RJTPP/S-ADAPT-IoT/docs/README.md

# Documentation Index

Current implementation source-of-truth docs are under `docs/architecture/` and `docs/planning/`.
Files under `docs/references/` are preserved reference artifacts and may describe earlier design intent.

## Architecture
- [`docs/architecture/Architecture.md`](architecture/Architecture.md)
- [`docs/architecture/business-logic.md`](architecture/business-logic.md)
- [`docs/architecture/Schematic_S-ADAPT.png`](architecture/Schematic_S-ADAPT.png)
- [`docs/architecture/design_EasyDEA.json`](architecture/design_EasyDEA.json)
- [`docs/user-guide.md`](user-guide.md)
- [`docs/feature-matrix.md`](feature-matrix.md)

## Planning
- [`docs/planning/planning-checklist.md`](planning/planning-checklist.md)
- [`docs/planning/test-checklist.md`](planning/test-checklist.md)

## References
- [`docs/references/Project Proposal.md`](references/Project%20Proposal.md)
- [`docs/references/Project Proposal_S-ADAPT-rev2.pdf`](references/Project%20Proposal_S-ADAPT-rev2.pdf)
- [`docs/references/NUCLEO-L432KC_pinout.png`](references/NUCLEO-L432KC_pinout.png)
