RJTPP/S-ADAPT-IoT/S-ADAPT/Core/Src/main.c

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
/* Includes ------------------------------------------------------------------*/
#include "main.h"

/* USER CODE BEGIN Includes */
#include "support/debug_print.h"
#include "app/app.h"
/* USER CODE END Includes */

ADC_HandleTypeDef hadc1;

I2C_HandleTypeDef hi2c1;

TIM_HandleTypeDef htim1;
TIM_HandleTypeDef htim2;

UART_HandleTypeDef huart2;

void SystemClock_Config(void);
static void MX_GPIO_Init(void);
static void MX_USART2_UART_Init(void);
static void MX_TIM2_Init(void);
static void MX_I2C1_Init(void);
static void MX_TIM1_Init(void);
static void MX_ADC1_Init(void);
/**
  * @brief  The application entry point.
  * @retval int
  */
int main(void)
{

  /* MCU Configuration--------------------------------------------------------*/

  /* Reset of all peripherals, Initializes the Flash interface and the Systick. */
  HAL_Init();

  /* Configure the system clock */
  SystemClock_Config();

  /* Initialize all configured peripherals */
  MX_GPIO_Init();
  MX_USART2_UART_Init();
  MX_TIM2_Init();
  MX_I2C1_Init();
  MX_TIM1_Init();
  MX_ADC1_Init();
  /* USER CODE BEGIN 2 */
  debug_print_init(&huart2);
  debug_print_set_level(DEBUG_PRINT_DEBUG);
  debug_println("Boot start");
  debug_println("App mode");
  {
    app_hw_config_t hw = {
      .ldr_adc = &hadc1,
      .echo_tim = &htim2,
      .echo_channel = TIM_CHANNEL_2,
      .main_led_tim = &htim1,
      .main_led_channel = TIM_CHANNEL_1
    };

    if (app_init(&hw) == 0U)
    {
      debug_logln(DEBUG_PRINT_ERROR, "app init degraded mode");
      app_set_fatal_fault(1U);
      debug_logln(DEBUG_PRINT_ERROR, "safe mode: fatal fault indication active");
    }
  }
  /* USER CODE END 2 */

  /* Infinite loop */
  /* USER CODE BEGIN WHILE */
  while (1)
  {
    app_step();
    HAL_Delay(1);
    /* USER CODE END WHILE */

    /* USER CODE BEGIN 3 */
  }
  /* USER CODE END 3 */
}

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
/* USER CODE BEGIN 4 */
void HAL_GPIO_EXTI_Callback(uint16_t GPIO_Pin)
{
  if ((GPIO_Pin == ENCODER_CLK_EXTI1_Pin) || (GPIO_Pin == ENCODER_DT_EXTI10_Pin))
  {
    encoder_input_on_clk_edge_isr();
  }
}
/* USER CODE END 4 */
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
