RJTPP/S-ADAPT-IoT/S-ADAPT/Core/Inc/main.h

#define TRIG_Pin GPIO_PIN_0
#define TRIG_GPIO_Port GPIOA
#define ECHO_TIM2_CH2_Pin GPIO_PIN_1
#define ECHO_TIM2_CH2_GPIO_Port GPIOA
#define VCP_TX_Pin GPIO_PIN_2
#define VCP_TX_GPIO_Port GPIOA
#define BUTTON_Pin GPIO_PIN_0
#define BUTTON_GPIO_Port GPIOB
#define ENCODER_CLK_EXTI1_Pin GPIO_PIN_1
#define ENCODER_CLK_EXTI1_GPIO_Port GPIOB
#define Main_LED_TIM1_CH1_Pin GPIO_PIN_8
#define Main_LED_TIM1_CH1_GPIO_Port GPIOA
#define ENCODER_PRESS_Pin GPIO_PIN_9
#define ENCODER_PRESS_GPIO_Port GPIOA
#define ENCODER_DT_EXTI10_Pin GPIO_PIN_10
#define ENCODER_DT_EXTI10_GPIO_Port GPIOA
#define LED_Status_B_Pin GPIO_PIN_11
#define LED_Status_B_GPIO_Port GPIOA
#define SWDIO_Pin GPIO_PIN_13
#define SWDIO_GPIO_Port GPIOA
#define SWCLK_Pin GPIO_PIN_14
#define SWCLK_GPIO_Port GPIOA
#define VCP_RX_Pin GPIO_PIN_15
#define VCP_RX_GPIO_Port GPIOA
#define LED_Status_R_Pin GPIO_PIN_4
#define LED_Status_R_GPIO_Port GPIOB
#define LED_Status_G_Pin GPIO_PIN_5
#define LED_Status_G_GPIO_Port GPIOB
#define OLED_I2C_SCL_Pin GPIO_PIN_6
#define OLED_I2C_SCL_GPIO_Port GPIOB
#define OLED_I2C_SDA_Pin GPIO_PIN_7
#define OLED_I2C_SDA_GPIO_Port GPIOB
