RJTPP/S-ADAPT-IoT/S-ADAPT/Core/Src/input/switch_input.c

#include "input/switch_input.h"

#include "input/input_utils.h"
#include "main.h"

#define SWITCH_SAMPLE_PERIOD_MS 10U
#define SWITCH_DEBOUNCE_TICKS   2U
#define SWITCH_EVENT_QUEUE_SIZE 8U

typedef struct
{
    uint8_t stable_level;
    uint8_t candidate_level;
    uint8_t candidate_ticks;
} switch_state_t;

typedef struct
{
    GPIO_TypeDef *port;
    uint16_t pin;
    switch_input_id_t id;
} switch_config_t;

#define SWITCH_INPUT_COUNT 2U

static const switch_config_t s_switch_configs[SWITCH_INPUT_COUNT] = {
    {BUTTON_GPIO_Port, BUTTON_Pin, SWITCH_INPUT_BUTTON},
    {ENCODER_PRESS_GPIO_Port, ENCODER_PRESS_Pin, SWITCH_INPUT_SW2},
};

static switch_state_t s_switch_states[SWITCH_INPUT_COUNT];
static uint32_t s_last_sample_ms = 0U;

static switch_input_event_t s_event_queue[SWITCH_EVENT_QUEUE_SIZE];
static uint8_t s_queue_head = 0U;
static uint8_t s_queue_tail = 0U;
static uint8_t s_queue_count = 0U;

static void init_switch_state(switch_state_t *state, const switch_config_t *config)
{
    uint8_t level = input_gpio_level(config->port, config->pin);
    state->stable_level = level;
    state->candidate_level = level;
    state->candidate_ticks = 0U;
}

static void queue_push(switch_input_id_t input, uint8_t level)
{
    switch_input_event_t event;
    uint32_t primask;

    primask = input_irq_lock();
    if (s_queue_count < SWITCH_EVENT_QUEUE_SIZE) {
        event.input = input;
        event.level = level;
        event.pressed = (level == 0U) ? 1U : 0U;

        s_event_queue[s_queue_tail] = event;
        s_queue_tail = (uint8_t)((s_queue_tail + 1U) % SWITCH_EVENT_QUEUE_SIZE);
        s_queue_count++;
    }
    input_irq_unlock(primask);
}

static void process_switch(switch_state_t *state, const switch_config_t *config)
{
    uint8_t raw_level = input_gpio_level(config->port, config->pin);

    if (raw_level != state->candidate_level) {
        state->candidate_level = raw_level;
        state->candidate_ticks = 1U;
        return;
    }

    if (state->candidate_ticks < SWITCH_DEBOUNCE_TICKS) {
        state->candidate_ticks++;
    }

    if ((state->candidate_ticks >= SWITCH_DEBOUNCE_TICKS) &&
        (state->stable_level != state->candidate_level)) {
        state->stable_level = state->candidate_level;
        queue_push(config->id, state->stable_level);
    }
}

void switch_input_init(void)
{
    uint32_t i;

    for (i = 0U; i < SWITCH_INPUT_COUNT; i++) {
        init_switch_state(&s_switch_states[i], &s_switch_configs[i]);
    }

    s_last_sample_ms = HAL_GetTick();

    s_queue_head = 0U;
    s_queue_tail = 0U;
    s_queue_count = 0U;
}

void switch_input_tick(uint32_t now_ms)
{
    uint32_t i;

    if (input_has_elapsed_ms(now_ms, s_last_sample_ms, SWITCH_SAMPLE_PERIOD_MS) == 0U) {
        return;
    }

    s_last_sample_ms = now_ms;

    for (i = 0U; i < SWITCH_INPUT_COUNT; i++) {
        process_switch(&s_switch_states[i], &s_switch_configs[i]);
    }
}

uint8_t switch_input_pop_event(switch_input_event_t *out_event)
{
    uint32_t primask;

    if (out_event == NULL) {
        return 0U;
    }

    primask = input_irq_lock();
    if (s_queue_count == 0U) {
        input_irq_unlock(primask);
        return 0U;
    }

    *out_event = s_event_queue[s_queue_head];
    s_queue_head = (uint8_t)((s_queue_head + 1U) % SWITCH_EVENT_QUEUE_SIZE);
    s_queue_count--;
    input_irq_unlock(primask);
    return 1U;
}
