RJTPP/S-ADAPT-IoT/(commit log)

2026-02-16 feat(core): add SSD1306 distance display and LED threshold logic
    Add SSD1306 font/display driver files and integrate OLED output in main loop.
    Update ultrasonic measurement flow and preserve I2C pull-up init in MSP user section.
2026-02-16 chore(cubemx): regenerate S-ADAPT project config and pin mappings
    Update CubeIDE/CubeMX metadata and refresh generated pin aliases in main.h.
    Adjust GPIO/I2C generated init code to use renamed symbols from S-ADAPT.ioc.
2026-02-18 fix(tim2): configure PA1 echo as TIM2 CH2 input capture
    [S-ADAPT.ioc, main.c, main.h]
2026-02-18 feat(board): add TIM1 PWM output and encoder GPIO mappings
2026-02-18 feat(adc): add ADC1 channel 9 and button input configuration
2026-02-19 feat(ultrasonic): modularize app loop and stabilize echo timing (#3)
    * Update .gitignore
    * fix(main): use status LED GPIO aliases for distance states
    * fix(ultrasonic): use TIM2 input capture for echo pulse timing
    * refactor(app): split main loop into app, display, and sensor modules
    * fix(ultrasonic): guard input capture against overcapture
    * Update .gitignore
    [app.c, display.c, main.c, status_led.c, ultrasonic.c]
2026-02-19 refactor(display): modularize app flow and migrate SSD1306 driver (#4)
    * feat(display): migrate to configurable ssd1306 driver and fonts
    * chore(gitignore): ignore imported ssd1306 source directory
    * Revert "chore(gitignore): ignore imported ssd1306 source directory"
    This reverts commit 77518cea64a4c4b0f35946473fedea99e98cb626.
    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
    [display.c]
2026-02-19 chore: ignore stm32cubeide.project.prefs
2026-02-19 chore/planing (#5)
    * Create Planning Checklist.md
    * Update Planning Checklist.md
    * Update Planning Checklist.md
    * docs(planning): add architecture, logic, calibration, and test guides
    * docs(structure): reorganize docs and add index links
    * docs(planning): remove calibration guide from planning docs
    * docs(planning): update light toggle and manual offset behavior
    * docs(planning): clarify encoder adjusts offset only
    * docs(structure): rename planning checklists to kebab-case
    * docs(planning): define auto-plus-offset control and overlay behavior
    * docs(architecture): clarify extra button as page switch input
2026-02-19 docs(structure): rename business logic doc to kebab-case
2026-02-19 feat(debug): add uart debug print module and boot logs
2026-02-19 feat(i2c): add startup I2C device scan logging
2026-02-19 feat(debug): add log levels and leveled UART logging (#6)
    * feat(ultrasonic): add measurement status codes and runtime logging
    * feat(debug): add log levels and leveled UART logging
2026-02-20 Feat/rgb led (#9)
    * feat(app): add state-driven status LED control flow
    * docs(architecture): update current RGB-first firmware design
2026-02-20 fix(app): gate display init behind bring-up flag
    [app.c]
2026-02-20 feat(ldr): add ADC LDR driver and periodic sampling (#8)
    * feat(ldr): add ADC LDR driver and periodic sampling
    * fix(ldr): calibrate ADC and report poll errors
    [ldr.c, main.c]
2026-02-20 Feat/switch (#7)
    * feat(input): add debounced switch event polling
    * Update Architecture.md
    * Rename SW to ENCODER_PRESS; update IOC & project
    Rename SW pin defines to ENCODER_PRESS in main.h and update the PA9 GPIO entry in S-ADAPT.ioc (label, add GPIO_PuPd and GPIO_PULLUP). Add a storageModule 'refreshScope' to .cproject and append MX_ADC1_Init to the ProjectManager.functionlistsort in the IOC file to include ADC initialization ordering.
    * refactor(input): generalize switch polling with config table
    * fix(input): protect switch event queue with irq lock
    * fix(input): read SW2 from encoder press pin
    [S-ADAPT.ioc, main.c, main.h, switch_input.c]
2026-02-20 Feat/encoder (#10)
    * feat(input): add encoder IRQ event handling
    * fix(input): support encoder press pin macros
    * fix(input): stabilize encoder init and dt pin setup
    [encoder_input.c, main.c]
2026-02-20 fix(app): preserve original boot timing baseline
    [app.c]
2026-02-20 feat(input): add full quadrature encoder decoding
2026-02-20 feat(main-led): add PWM driver and debug sweep control (#15)
2026-02-20 docs(planning): capture driver-first snapshot and next-phase order
2026-02-20 Feat/business logic baseline (#16)
    * feat(app): move baseline control loop into app runtime
    * fix(app): mark any non-zero offset as RGB offset state
    * feat(status-led): add light-off state and refine RGB mapping
    * fix(app): correct click window timing and init fault handling
    * refactor(app): split config/state and use hw config struct
    [app.c, main.c, status_led.c]
2026-02-20 fix(debug): chunk UART logs and expand format buffer
    [debug_print.c]
2026-02-20 Feat/stability filters (#17)
    * feat(app): add sensor filtering and output hysteresis
    * fix(debug): chunk UART logs and expand format buffer
    * fix(app): increase output hysteresis band to 5 percent
    * fix(app): force immediate zero output and clean MA update
    [app.c, filter_utils.c]
2026-02-20 feat(app): add ramp-limited PWM output after hysteresis (#18)
    * feat(app): add ramp-limited PWM output after hysteresis
    * feat(app): add separate PWM ramp steps for on and off
    * feat(app): decouple sampling cadence and tune PWM ramp rates (#19)
    * feat(app): decouple sampling cadence and tune PWM ramp rates
    * fix(app): decouple periodic schedulers from loop jitter
    [app.c]
2026-02-20 Feat/user detection (#22)
    * feat(app): add reference-based presence engine with pre-off dim
    * feat(app): add debug timer overrides for presence tuning
    * docs(app): clarify presence debug timer macro usage
    * Update app.c
    * fix(app): gate motion streak updates to flat recovery state
    * fix(app): simplify flat-condition check to reference delta
    * fix(app): debounce away recovery with return confirmation window
    * fix(app): tune presence return band and step-based motion logic
    * fix(app): tune motion recovery sensitivity and decay
    * fix(app): reset presence streaks on recovery transitions
    * chore(app): sync presence docs and remove unused delta var
    * docs(planning): update presence dete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
    [app.c, app_control.c, app_events.c, app_sensors.c, app_ui.c]
2026-02-21 refactor(app): extract presence runtime state reset helper
    [app_events.c]
2026-02-21 fix(app): increase presence motion delta threshold
    [app.c]
2026-02-21 Feat/oled page (#24)
    * feat(ui): add multi-page OLED runtime interface
    * fix(ui): adjust OLED page layout and sensor labels
    * fix(ui): render full-width OLED progress bars
    * fix(ui): correct LDR percentage scaling
    * fix(ui): clarify offset label on main OLED page
    * feat(ui): add staged OLED boot progress screen
    * feat(ui): add main-page OLED status badges
    * fix(ui): simplify leave badge selection logic
    * fix(ui): show leave badge during away streak
    * perf(ui): render OLED only on page-relevant data changes
    * perf(ui): rate-limit OLED redraw bursts
    * fix(input): reduce switch debounce ticks
    * refactor(ui): centralize display constants and remove legacy distance API
    [app.c, app_events.c, app_ui.c, display.c, switch_input.c]
2026-02-21 fix(ui): center boot title based on font width
    [display.c]
2026-02-21 fix(control): apply fast-on ramp only after light toggle (#25)
    [app.c, app_control.c, app_events.c]
2026-02-21 fix(ui): complete overlay animation before auto-hide
    [app_ui.c]
2026-02-21 fix(ui): always show overlay on encoder input when light is on
    [app_events.c]
2026-02-21 fix(control): gate fast-on ramp reset to active state
    [app_control.c]
2026-02-21 docs(architecture): update runtime flow to app-based design
2026-02-21 docs: align architecture and planning docs with current runtime profile
2026-02-21 docs(readme): add hardware overview schematic image
2026-02-21 fix(runtime): harden presence, PWM, and OLED I2C behavior
    [app.c, app_events.c, app_sensors.c, app_ui.c, main_led.c]
2026-02-21 fix(ui): align OLED badge baseline and invert box
    [display.c]
2026-02-21 fix(sensors): make ultrasonic delay robust to timer wrap
    [ultrasonic.c]
2026-02-21 docs(hardware): update references for isolated MOSFET lamp module
2026-02-21 feat(app): add persistent on-device settings mode
    Add a modal OLED settings flow controlled via button long-press and encoder input with draft edits, save/reset/exit actions, and toast status feedback.
    Persist runtime settings in reserved internal flash using append-only versioned records with CRC validation and boot-time restore/default fallback.
    Wire configurable thresholds/timers into presence and control paths, reserve 2KB flash page in linker script, and update architecture/planning/test docs.
    [app.c, app_control.c, app_events.c, app_sensors.c, app_settings.h, app_ui.c, display.c]
2026-02-21 chore(ide): update stm32cubeide project prefs
2026-02-21 fix(app): enforce stepped settings increments
    Apply 5-unit steps for configurable timeouts and return band in settings edit flow and validation.
    Update bounds to step-aligned minima and normalize loaded/saved values to valid step buckets.
    [app_events.c, app_settings.h, settings_store.c]
2026-02-21 chore(ide): refresh stm32cubeide project prefs
2026-02-21 feat(display): invert unsaved exit warning label
    Highlight the selected "Exit?" label with inverted text to make unsaved-exit risk more visible.
    [display.c]
2026-02-21 refactor(app): track settings long-press state
    Add long_press_fired to settings UI state and initialize/reset it during app init and settings mode transitions.
    [app.c, app_events.c]
2026-02-21 fix(app): trigger settings long-press while button is held
    Move long-press detection to the pressed state so mode toggle fires once at threshold, then suppress release-side page switching.
    [app_events.c]
2026-02-21 feat(app): wrap timeout values in settings editor
    Add wrap_settings_u16 and use it for away/flat/preoff timeout rows so encoder rotation wraps min/max bounds instead of hard-clamping.
2026-02-21 feat(app): wrap return-band value in settings editor
    Use wrap-around stepping for return-band edits so encoder movement cycles between configured min and max limits.
2026-02-21 docs(architecture): update app_step flow with settings routing
2026-02-21 Refactor/clean up (#31)
    * refactor(settings): move defaults and validation into app module
    * refactor(display): split settings page rendering helpers
    * refactor(app): remove unused encoder offset variable
    * build(app): add stddef include for NULL
2026-02-21 feat(app): switch encoder reset from double to long press
    [app.c, app_events.c]
2026-02-21 docs: update encoder interaction to short and long press
2026-02-21 fix(app): fire encoder long press while button is held
    [app.c, app_events.c]
2026-02-22 docs(readme): update release target and driver link
2026-02-22 fix(ui): refine main badge state transitions
    [app_ui.c]
2026-02-22 fix(ui): tighten away badge selection logic
    [app_ui.c]
2026-02-22 docs(readme): add power topology note for wiring options
2026-02-22 docs(user-guide): add status LED color meaning section
